DocMuerde/Speed-fan-control-Matlab/Fondo.stl

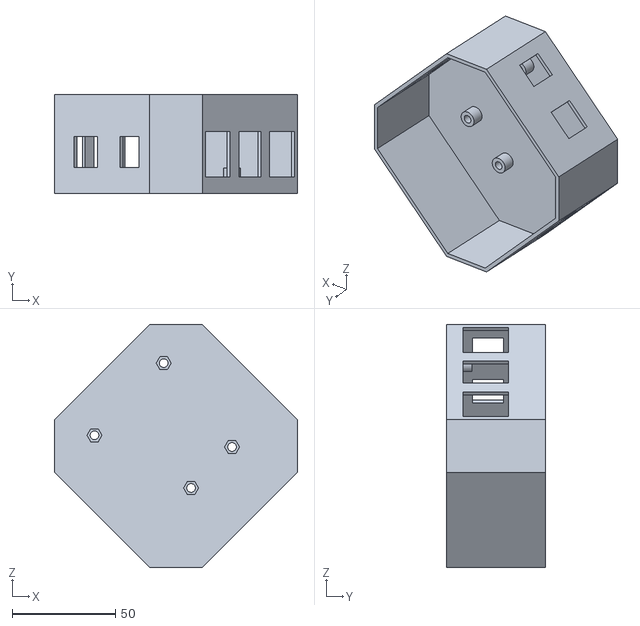
[picture p11: CAD file, 2023-03-22]
Fondo.stl
117.4 x 48.0 x 117.4
