DocMuerde/Speed-fan-control-Matlab/Tapa_Ventlador_Arriba.stl

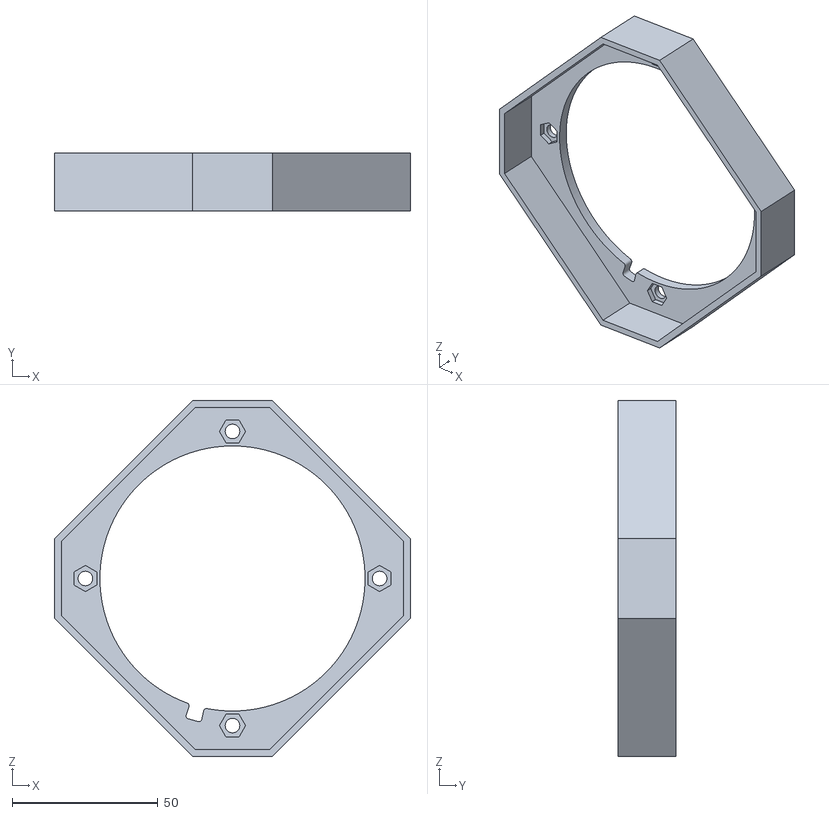
[picture p12: CAD file, 2023-03-22]
Tapa_Ventlador_Arriba.stl
122.2 x 20.0 x 122.2
